hoang24/ece411-practicum/README.md

# Team 4: ECE 411 Practicum Repo

This is Team 4's Github repo for ECE411 Practicum. Codes and documents such as Product Design Specification (PDS) and Project Ideas can be found here.

### Team members:
- Jonathan Christian
- Hoang Nguyen
- Ngan Ho
- Karla Barraza
