hoang24/ece411-practicum/Schematics/Info.txt

This folder will hold the schematics for our project.
