hoang24/ece411-practicum/images/ece411_proto1_img0.jpeg

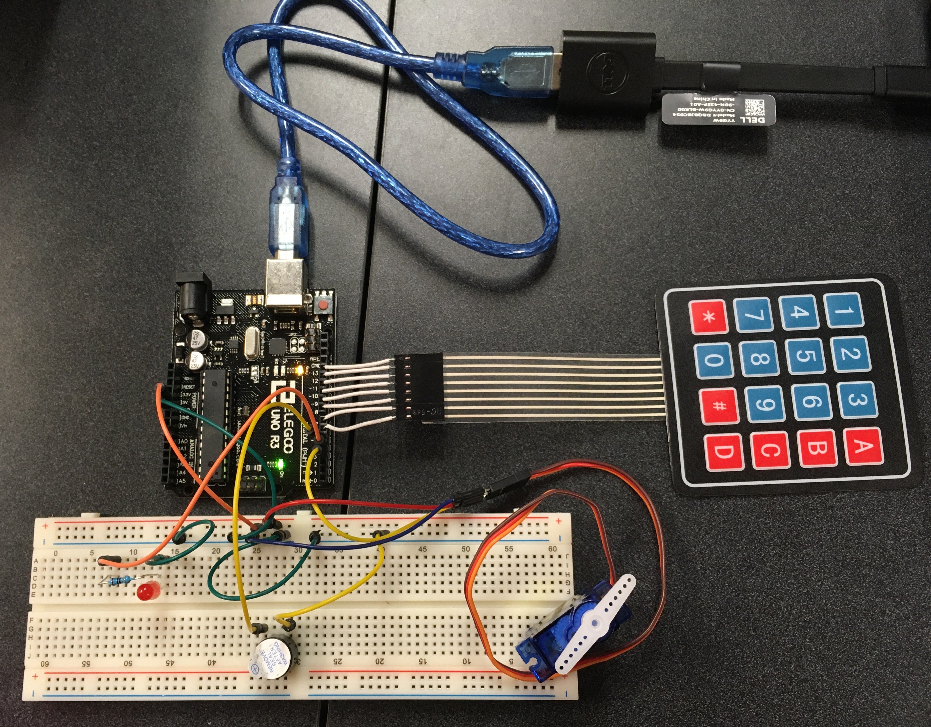
images/ece411_proto1_img0.jpeg
