hoang24/ece411-practicum/images/erc.png

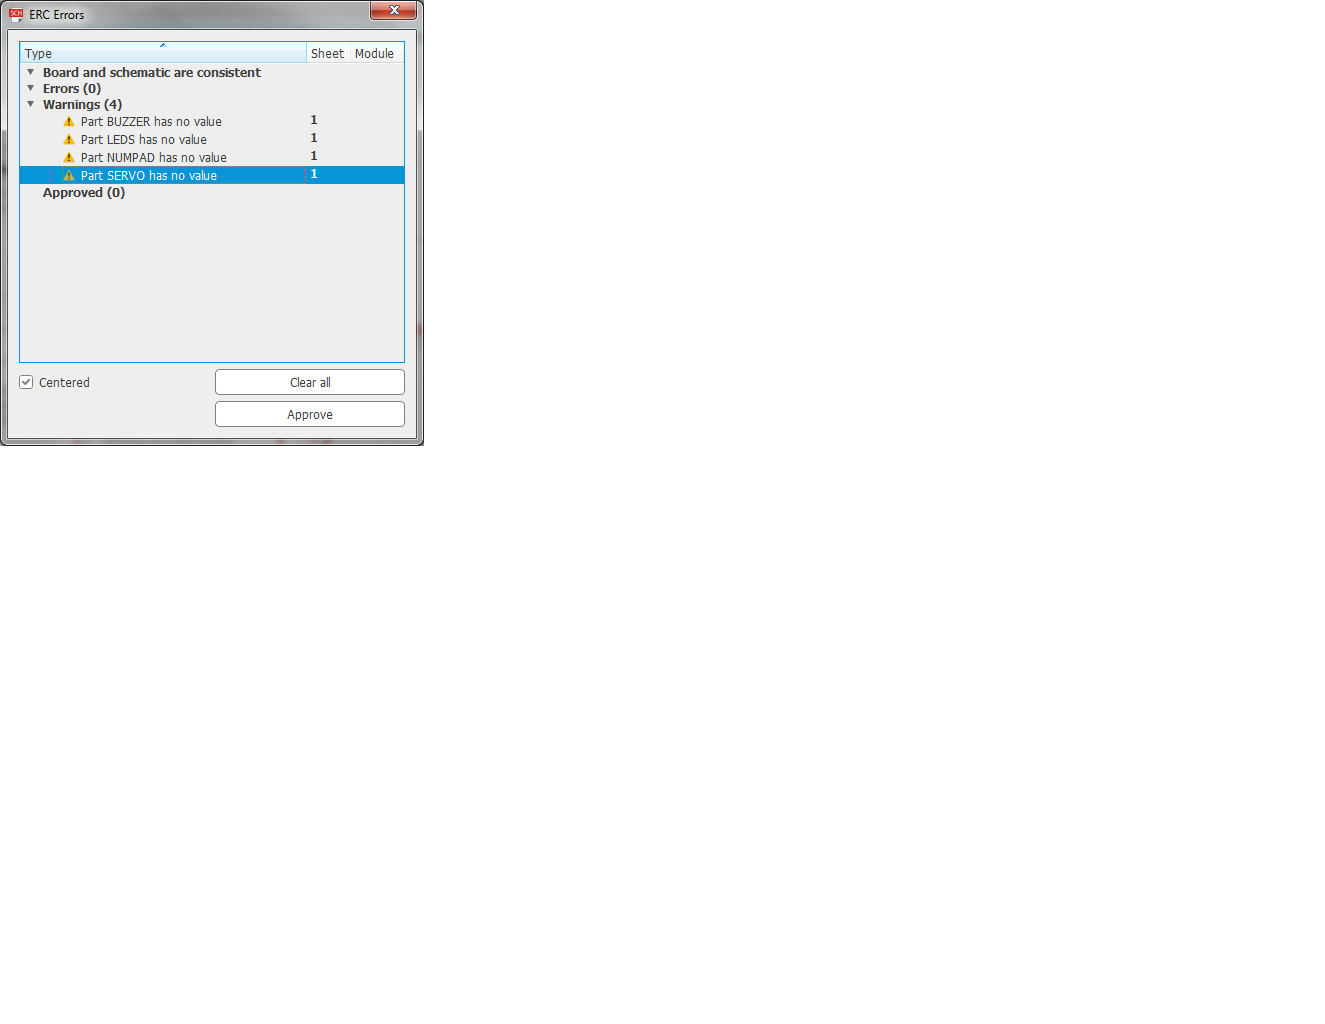
images/erc.png
