hoang24/ece411-practicum/images/LockBox.JPG

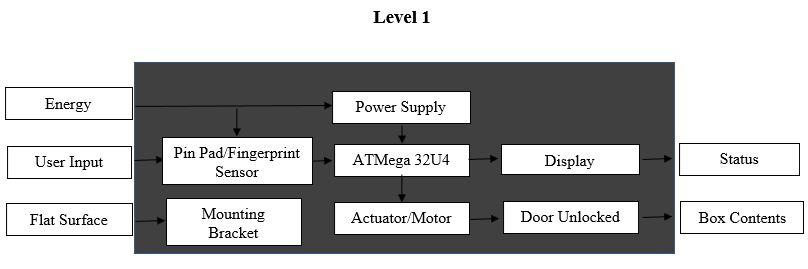
images/LockBox.JPG
