hoang24/ece411-practicum/docs/Current BOM - BOM per Board.pdf

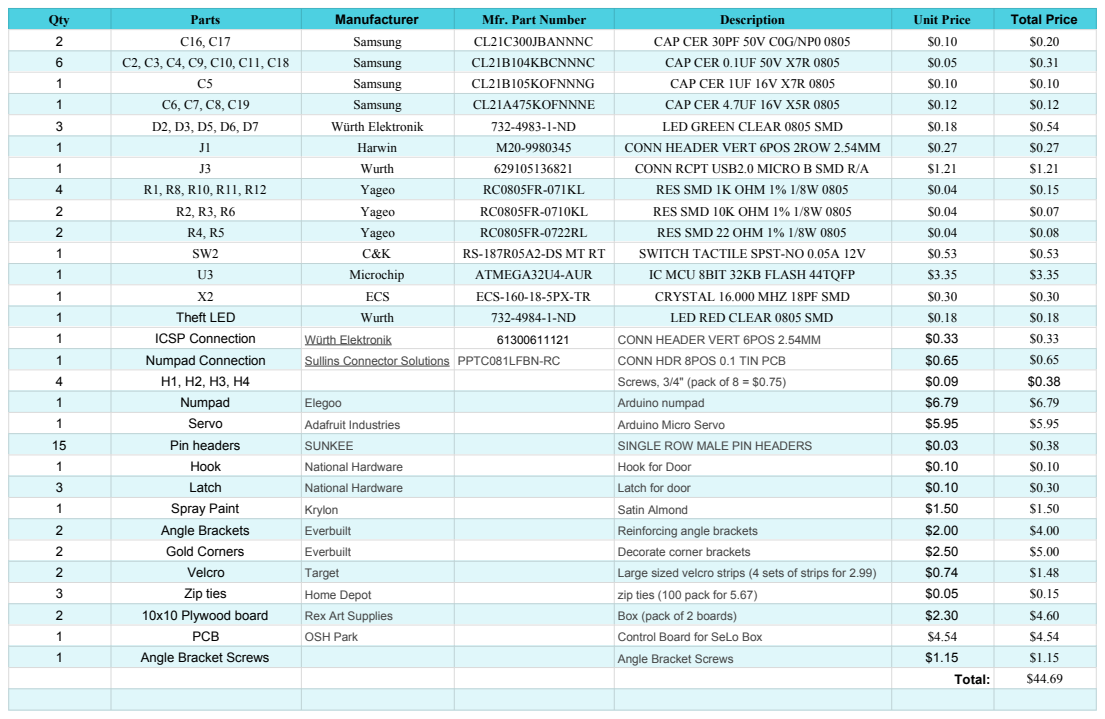
[picture p13: page 1]
