hoang24/ece411-practicum/eagle/ver2_usb/team4-selo-atmega32u4-usb.brd

## EAGLE design eagle/ver2_usb/team4-selo-atmega32u4-usb.brd (2019-11-21)

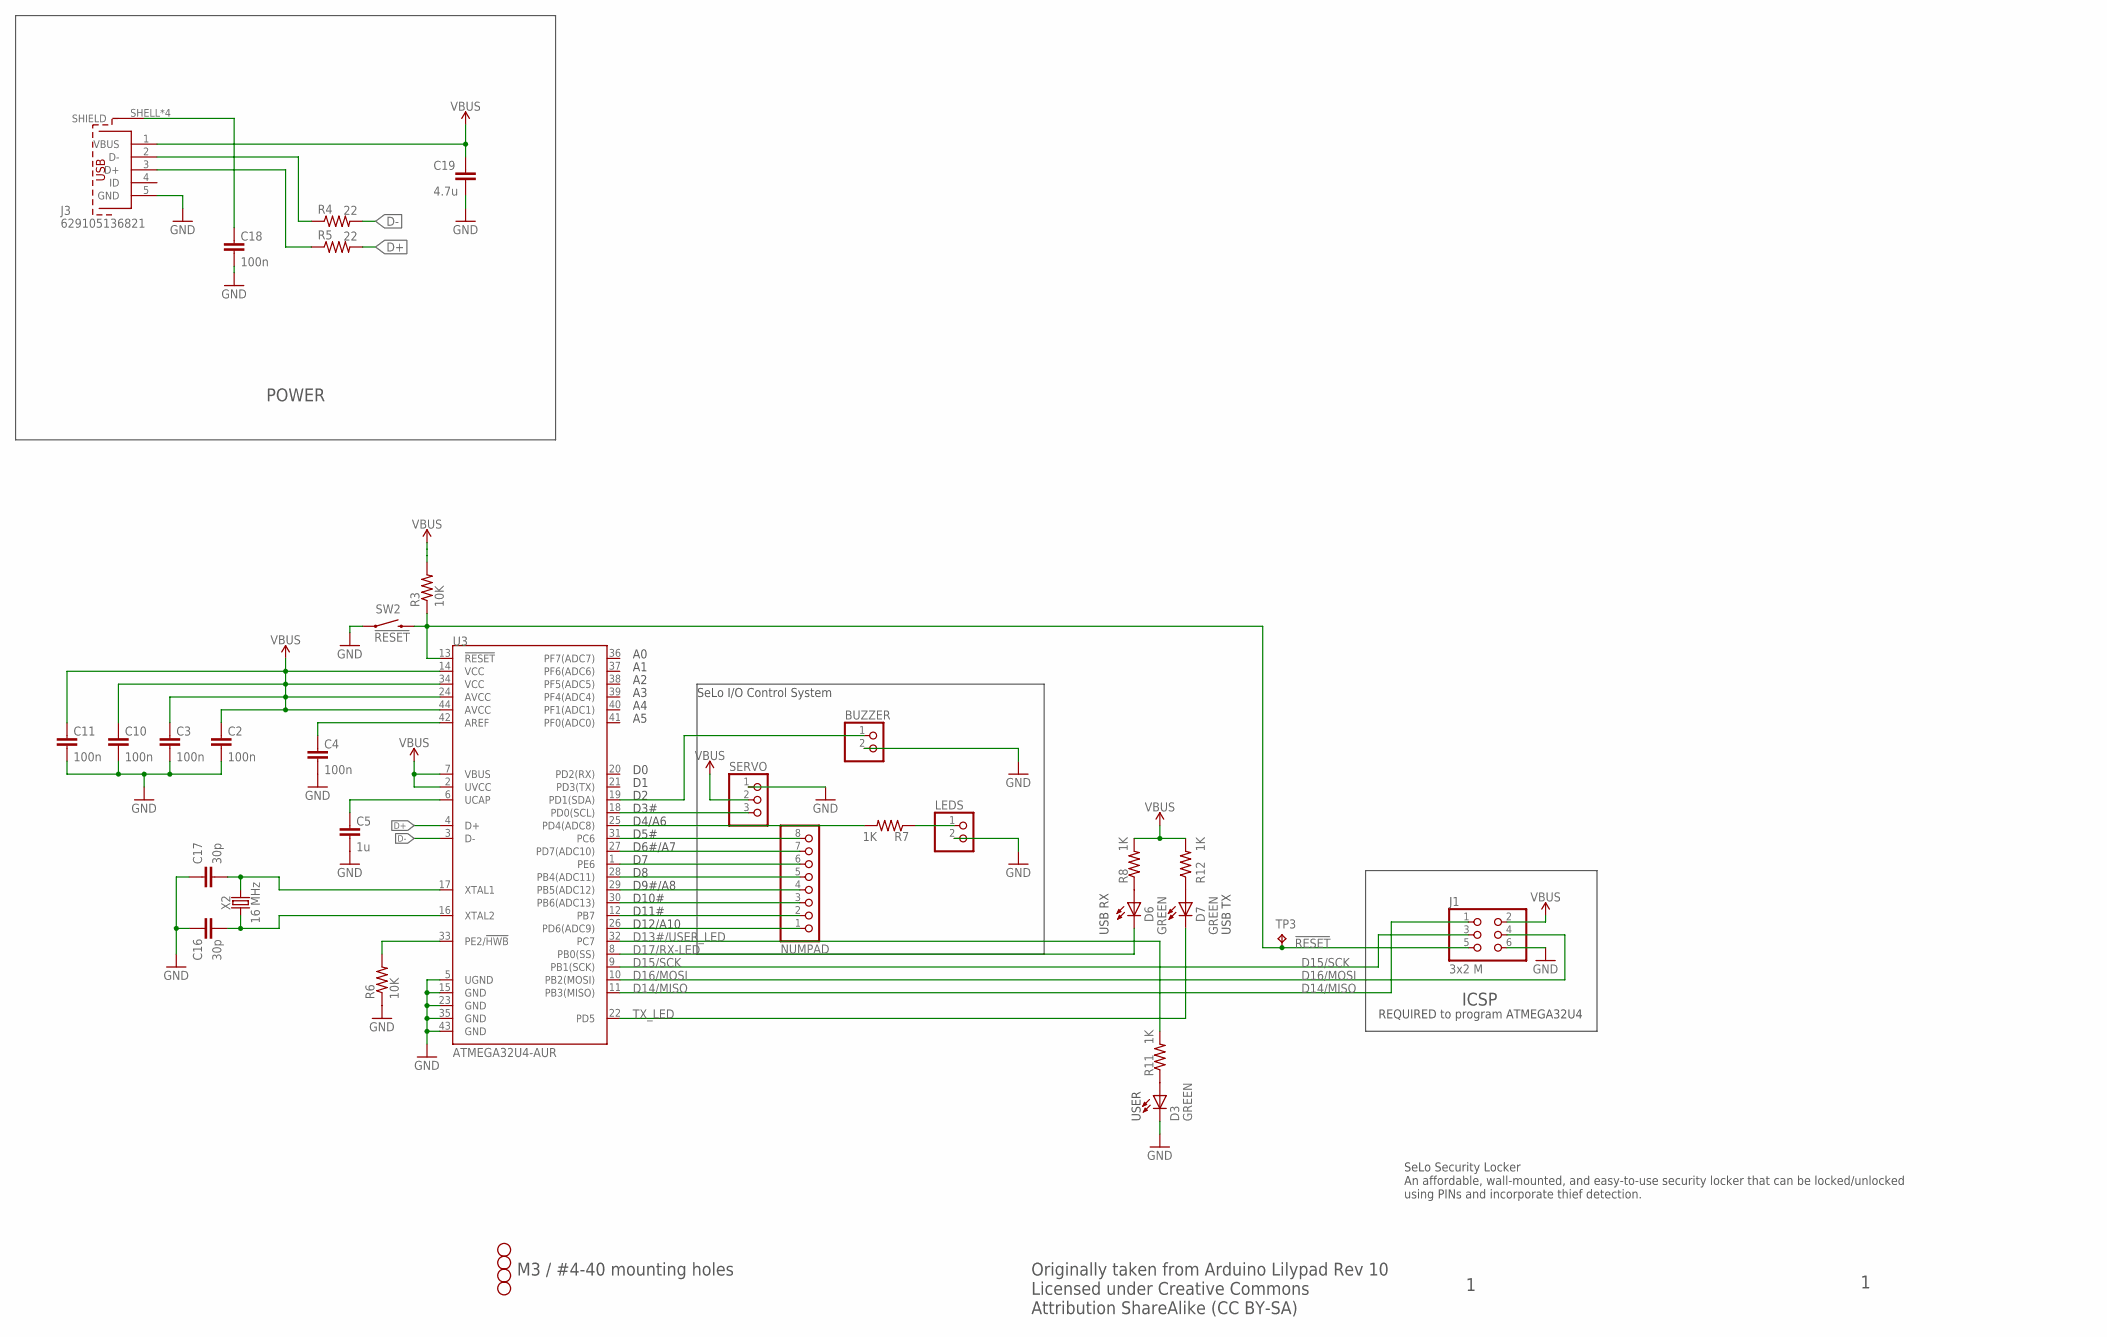
[picture p14: schematic team4-selo-atmega32u4-usb.sch, sheet 1]

Parts:
BUZZER: PINHD-1X2; 1X02
C2, C3, C4, C10, C11, C18: 100n; C0805K; MPN CL21B104KBCNNNC
C5: 1u; C0805K; MPN CL21B105KOFNNNG
C16: 30p; C0805K; MPN CL21C300JBANNNC
C17: 30p; C0805K; MPN CL21C180JBANNNC
C19: 4.7u; C0805K; MPN CL21A475KOFNNNE
D3, D6, D7: GREEN; CHIP-LED0805; MPN 150080GS75000
H1, H2, H3, H4: STAND-OFF
J1: 3x2 M; 2X03; MPN M20-9980345
J3: 629105136821; MPN 629105136821
LEDS: PINHD-1X2; 1X02
NUMPAD: PINHD-1X8; 1X08
R3, R6: 10K; R0805; MPN RC0805FR-0710KL
R4, R5: 22; R0805; MPN RC0805FR-0722RL
R7, R8, R11, R12: 1K; R0805; MPN RC0805FR-071KL
SERVO: PINHD-1X3; 1X03
SW2: !RESET; TACTILE_SWITCH_SMD; MPN RS-187R05A2-DS MT RT
TP3: TPPAD1-13; P1-13
U3: ATMEGA32U4-AUR; TQFP44; MPN ATMEGA32U4-AUR
X2: 16 MHz; HC49UP; MPN ECS-160-18-5PX-TR

Connections:
!RESET: J1.5, R3.1, SW2.3 (2), TP3.TP, U3.13 (!RESET)
AREF: C4.1, U3.42 (AREF)
D13#/USER_LED: R11.2, U3.32 (PC7)
D14/MISO: J1.1, U3.11 (PB3(MISO))
D15/SCK: J1.3, U3.9 (PB1(SCK))
D16/MOSI: J1.4, U3.10 (PB2(MOSI))
D17/RX-LED: D6.C, U3.8 (PB0(SS))
D+: R5.2, U3.4 (D+)
D-: R4.2, U3.3 (D-)
GND: BUZZER.2, C2.2, C3.2, C4.2, C5.2, C10.2, C11.2, C16.2, C17.2, C18.2, C19.2, D3.C, J1.6, J3.5 (GND), LEDS.2, R6.1, SERVO.1, SW2.1, U3.5 (UGND), U3.15 (GND), U3.23 (GND), U3.35 (GND), U3.43 (GND)
unnamed: SERVO.3, U3.18 (PD0(SCL))
unnamed: NUMPAD.8, U3.31 (PC6)
unnamed: NUMPAD.7, U3.27 (PD7(ADC10))
unnamed: NUMPAD.6, U3.1 (PE6)
unnamed: NUMPAD.5, U3.28 (PB4(ADC11))
unnamed: NUMPAD.4, U3.29 (PB5(ADC12))
unnamed: NUMPAD.3, U3.30 (PB6(ADC13))
unnamed: NUMPAD.2, U3.12 (PB7)
unnamed: NUMPAD.1, U3.26 (PD6(ADC9))
unnamed: D3.A, R11.1
unnamed: C18.1, J3.SHELL (SHIELD), J3.SHELL1 (SHIELD), J3.SHELL2 (SHIELD), J3.SHELL3 (SHIELD)
unnamed: D6.A, R8.1
unnamed: D7.A, R12.1
unnamed: R7.2, U3.25 (PD4(ADC8))
unnamed: LEDS.1, R7.1
unnamed: J3.2 (D-), R4.1
unnamed: J3.3 (D+), R5.1
unnamed: BUZZER.1, U3.19 (PD1(SDA))
PE2/!HWB: R6.2, U3.33 (PE2/!HWB)
TX_LED: D7.C, U3.22 (PD5)
UCAP: C5.1, U3.6 (UCAP)
VBUS: C2.1, C3.1, C10.1, C11.1, C19.1, J1.2, J3.1 (VBUS), R3.2, R8.2, R12.2, SERVO.2, U3.2 (UVCC), U3.7 (VBUS), U3.14 (VCC), U3.24 (AVCC), U3.34 (VCC), U3.44 (AVCC)
XTAL1: C17.1, U3.17 (XTAL1), X2.2
XTAL2: C16.1, U3.16 (XTAL2), X2.1

Notes on the sheet:
Originally taken from Arduino Lilypad Rev 10 Licensed under Creative Commons Attribution ShareAlike (CC BY-SA)
POWER
M3 / #4-40 mounting holes
ICSP
REQUIRED to program ATMEGA32U4
USB RX
USB TX
USER
D3#
D4/A6
D5#
D6#/A7
D9#/A8
D10#
D11#
D12/A10
SeLo I/O Control System
SeLo Security Locker An affordable, wall-mounted, and easy-to-use security locker that can be locked/unlocked using PINs and incorporate thief detection.

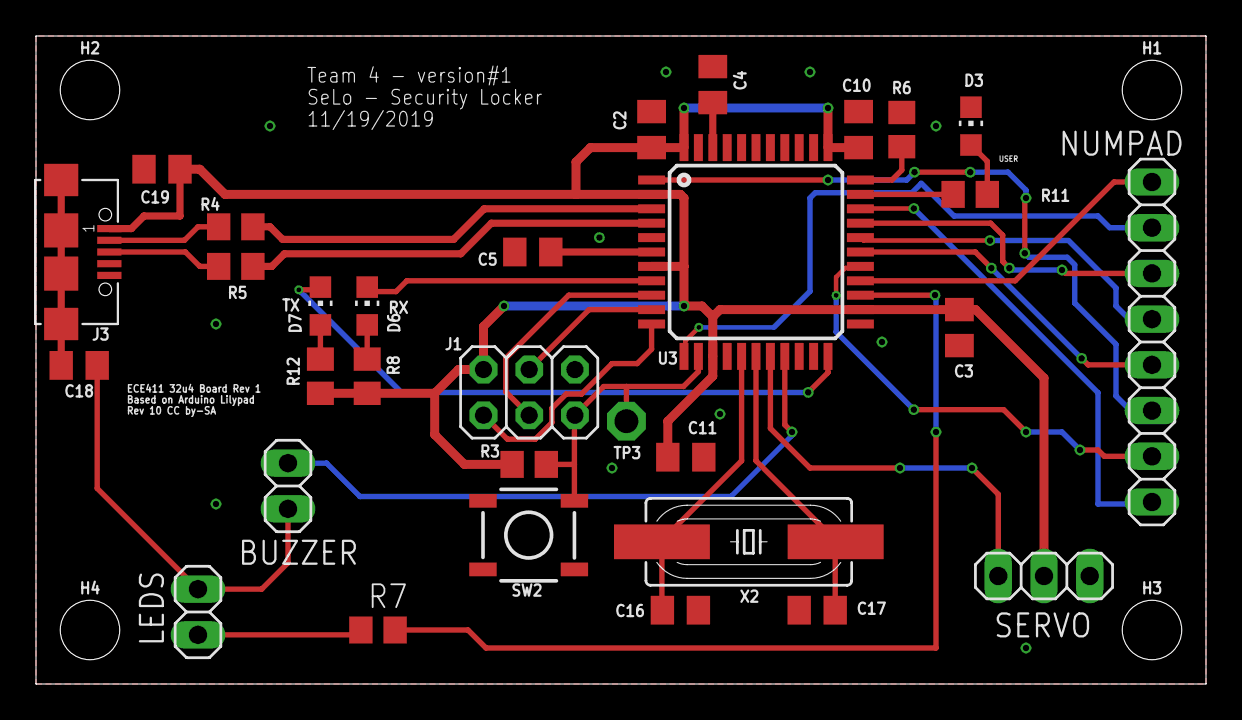
[picture p15: board team4-selo-atmega32u4-usb.brd from above]

Board: 2 copper layers, 65.0 x 36.0 mm, 35 parts (0 on the bottom side), 34 nets.
