hoang24/ece411-practicum/tests/unittest_servo/unittest_servo.ino

#include <Servo.h> 
int servoPin = 3; 
Servo Servo1; 
void setup() { 
   Servo1.attach(servoPin); 
}
void loop(){ 
   // Make servo go to 0 degrees 
   Servo1.write(0); 
   delay(1000); 
   // Make servo go to 90 degrees 
   Servo1.write(90); 
   delay(1000); 
   // Make servo go to 180 degrees 
   Servo1.write(180); 
   delay(1000); 
}
