hoang24/ece411-practicum/(commit log)

2019-10-29 add codes for prototype 1
2019-10-31 add pictures and video of 1st prototype
2019-10-31 Upload initial schematic
    [Project schematic.sch]
2019-11-05 update selo schematics
    [Project schematic.sch, team4-selo-atmega32u4.brd, team4-selo-atmega32u4.sch]
2019-11-07 put eagle files to archives
    [team4-selo-atmega32u4.brd, team4-selo-atmega32u4.sch]
2019-11-07 add new eagle files
    [team4-selo-atmega32u4-old.brd, team4-selo-atmega32u4-old.sch, team4-selo-atmega32u4.brd, team4-selo-atmega32u4.sch]
2019-11-07 update eagle schematic and board
    [team4-selo-atmega32u4-usb.brd, team4-selo-atmega32u4-usb.sch, team4-selo-atmega32u4.brd, team4-selo-atmega32u4.sch]
2019-11-11 Add bill of materials
    [Product_BOM.xlsx]
2019-11-14 rename and delete unnecessary files
    [Project schematic.sch, team4-selo-atmega32u4-old.brd, team4-selo-atmega32u4-old.sch, team4-selo-atmega32u4-usb.brd, team4-selo-atmega32u4-usb.sch, team4-selo-atmega32u4.brd, team4-selo-atmega32u4.sch]
2019-11-14 edit board layout file
    [team4-selo-atmega32u4-usb.brd]
2019-11-14 move battery version board and schematics to archives
    [team4-selo-atmega32u4.brd, team4-selo-atmega32u4.sch]
2019-11-14 Update BOM
    [Product_BOM.xlsx]
2019-11-16 reroute on eagle board, update gitignore
    [team4-selo-atmega32u4-usb.brd]
2019-11-18 update eagle board
    [team4-selo-atmega32u4-usb.brd]
2019-11-18 check with DRC
    [team4-selo-atmega32u4-usb.brd]
2019-11-18 add info to schematic
    [team4-selo-atmega32u4-usb.sch]
2019-11-19 Update code for 328p dev board
2019-11-19 update board layout
    [team4-selo-atmega32u4-usb.brd]
2019-11-20 update board and schematic
    [team4-selo-atmega32u4-usb.brd, team4-selo-atmega32u4-usb.sch]
2019-11-20 edit tnames layer
    [team4-selo-atmega32u4-usb.brd]
2019-11-21 final update to eagle board
    [team4-selo-atmega32u4-usb.brd]
2019-11-21 add ratsnet
    [team4-selo-atmega32u4-usb.brd]
2019-12-04 update code, controlSys_2 works on PCB
2019-12-04 add 2 testcases for LED and servo
2019-12-10 Add files via upload
    Add new BOM
2019-12-10 Delete Product_BOM.xlsx
    Updating BOM, removing old one
    [Product_BOM.xlsx]
2019-12-10 update PDS to rev. 3, rearrage BOM
