hoang24/ece411-practicum/(notices)

Notices in the files:
eagle/ver2_usb/team4-selo-atmega32u4-usb.brd:
Rev 10 CC by-SA
parts and their libraries:
SparkFun-PowerIC: Licensing: CC v3.0 Share-Alike You are welcome to use this library for commercial purposes.
SparkFun-IC-Microcontroller: Licensing: Creative Commons ShareAlike 4.0 International - https://creativecommons.org/licenses/by-sa/4.0
